wherediddavidgo/ctdTURBO/bill of materials.xlsx

Sheet: components
Part Name | Amount needed per unit | Cost per unit | Cumulative cost | Link to purchase
Adafruit Feather M0 Adalogger | 1 | $25.63 | $25.63 | https://www.amazon.com/Adafruit-Feather-M0-Adalogger-ADA2796/dp/B01BMRDBXW?hvadid=167151358503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
DS3231 Precision RTC FeatherWing | 1 | $13.95 | $39.58 | https://www.digikey.com/en/products/detail/adafruit-industries-llc/3028/5885910?gad_source=1
Female header pins | 1 | $0.16 | $39.74 | https://www.amazon.com/Qunqi-2-54mm-Straight-Connector-Arduino/dp/B07CGGSDWF
Custom PCB | 1 | $0.44 | $40.18
Atlas Scientific EZO-DO Dissolved Oxygen Embedded Circuit | 1 | $52.99 | $93.17 | https://www.amazon.com/Atlas-Scientific-EZO-DO-Dissolved-Embedded/dp/B0078WUJUO
Atlas Scientific EZO-EC Embedded Conductivity Circuit | 1 | $53.99 | $147.16 | https://www.amazon.com/Atlas-Scientific-EZO-EC-Embedded-Conductivity/dp/B006ERPKLM
5200mAh 3.7v Lithium Ion Battery | 1 | $16.98 | $164.14 | https://www.amazon.com/Rechargeable-Batteries-Electronics-Equipment-Bluetooth/dp/B0B1JKSY46
CR1220 Battery | 1 | $1.35 | $165.49 | https://www.amazon.com/Energizer-CR1220-Drain-lithuim-Battery/dp/B003CU3E2Q
10kΩ resistor | 3 | $0.30 | $165.79 | https://www.digikey.com/en/products/detail/yageo/MFR-25FRF52-10K/14626
4.7kΩ resistor | 1 | $0.10 | $165.89 | https://www.digikey.com/en/products/detail/yageo/MFR25SFTF52-4K7/9144664
22 Gauge Solid Core Wire, multiple colors |  | $14.99 | $180.88 | https://www.amazon.com/TUOFENG-Hookup-Wires-6-Different-Colored/dp/B07TX6BX47
0.1μF capacitor | 1 | $0.24 | $181.12 | https://www.digikey.com/en/products/detail/vishay-beyschlag-draloric-bc-components/K104K15X7RF5TL2/286538
Slide switch | 1 | $0.76 | $181.88 | https://www.digikey.com/en/products/detail/e-switch/EG1218/101726
JST 2 pin connector kit | 1 | $0.60 | $182.48 | https://www.amazon.com/Letool-Electrical-Female-Connector-Cables/dp/B07FP2FCYC
Atlas Scientific Mini Lab Grade Dissolved Oxygen Probe | 1 | $134.99 | $317.47 | https://www.amazon.com/Atlas-Scientific-Grade-Dissolved-Oxygen/dp/B08MB98D98
Atlas Scientific Mini Conductivity Probe | 1 | $123.99 | $441.46 | https://www.amazon.com/Atlas-Scientific-Mini-Conductivity-Probe/dp/B08MBDSRS1
DS18B20 Temperature Sensor | 1 | $2.40 | $443.86 | https://www.amazon.com/HiLetgo-DS18B20-Temperature-Stainless-Waterproof/dp/B00M1PM55K
MS580314BA01-00 Pressure Sensor | 1 | $20.93 | $464.79 | https://www.digikey.com/en/products/detail/te-connectivity-measurement-specialties/MS580314BA01-00/5277631
SOIC DIP 8 pin adapter | 1 | $0.88 | $465.66 | https://www.digikey.com/en/products/detail/sparkfun-electronics/BOB-13655/5528943
VCNL4010 Light Sensor | 1 | $7.99 | $473.65 | https://www.amazon.com/RAKSTORE-VCNL4010-Proximity-Sensor-3-3-5V/dp/B0CMD33Z24
3D printed endcap | 1 | $15.00 | $488.65
2 inch schedule 40 PVC pipe | 1 ft | $8.20 | $496.85 | https://www.amazon.com/2-1-Schedule-40-PVC-Pipe/dp/B0C549J61Q?hvadid=580698540421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
2 inch test plug | 1 | $5.29 | $502.14 | https://www.amazon.com/Pipe-Plug-Mechanical-Size-270229/dp/B000R84XB2

Sheet: consumables
Material | Cost | Sensors per unit | Link to Purchase
63-37 Sn Pb rosin-core solder (0.8 mm) | $8.99 | > 20 | https://www.amazon.com/MAIYUM-63-37-Solder-Electrical-Soldering/dp/B075WB98FJ?th=1
Electrical tape | $2.78 | > 20 | https://www.amazon.com/Scotch-Heat-Resistant-Listed-Certified-Electrical/dp/B001AXD0EY?s=hi
Teflon tape | $5.99 | > 20 | https://www.amazon.com/Inches-Plumbers-Plumbing-Plumber-Sealing/dp/B091913Z7F?s=hi
VViViD optically clear epoxy | $33.99 | > 20 | https://www.amazon.com/VViViD-Optically-Clear-2-Part-Coating/dp/B079Y9QFQS?s=hi
5 oz paper cups | $16.19 | > 20 | https://www.amazon.com/Clawsoff-Disposable-Bathroom-Mouthwash-Barbecues/dp/B0BXD8L2W7
Popsicle sticks | $4.99 | > 20 | https://www.amazon.com/Sticks-Natural-Popsicle-Length-Crafts/dp/B07F367TCK
PVC cement and primer | $4.88 | > 20 | https://www.amazon.com/15900-Regular-Bodied-Plumbing-Solvent-Cement/dp/B0BWZ257RX
Nitrile gloves | $7.90 | > 20 | https://www.amazon.com/Supmedic-Nitrile-Disposable-Powder-Free-Latex-Free/dp/B0C9S5PMSD

Sheet: tools
Tool | Cost | Link to Purchase
Soldering iron | $12.98 | https://www.amazon.com/Liouhoum-Auto-Sleep-Adjustable-Temperature-Thermostatic/dp/B08PZBPXLZ?s=hi
Heat gun | $16.99 | https://www.amazon.com/Yeegewin-Reflector-Embossing-Wrapping-Stripping/dp/B09MCZNY5J?s=hi
Glossy silicone mat | $6.71 | https://www.amazon.com/Silicone-Jewelry-Casting-Multi-Purpose-Placemat/dp/B07XFJ5YKN
Wire stripper | $8.39 | https://www.amazon.com/WGGE-Professional-crimping-Multi-Tool-Multi-Function/dp/B073YG65N2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
Wire cutter | $5.47 | https://www.amazon.com/Hakko-CHP-170-Micro-Cutter/dp/B00FZPDG1K?s=hi
Tweezers | $6.99 | https://www.amazon.com/Precision-Anti-Static-Electronics-Sodlering%EF%BC%8CJewelry-Laboratory/dp/B07ZBZ7MSF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
