wherediddavidgo/ctdTURBO/hardware/endcap/openctdturbo v15.stl

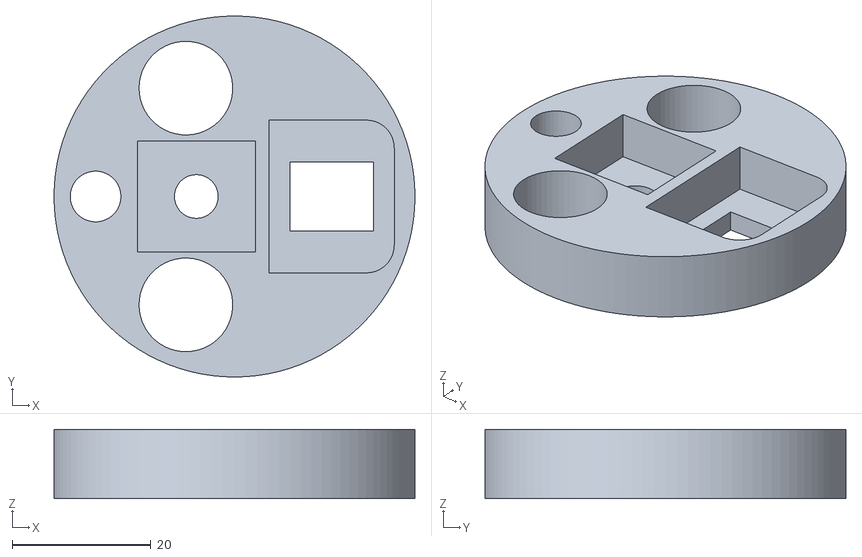
[picture p17: CAD file, 2024-02-19]
hardware/endcap/openctdturbo v15.stl
52.0 x 52.0 x 10.0
